ChanceyLab/STM32_F1_GestureRecognition/FDC2214芯片/FDC2214配套资料/看资料之前首先看我哦.pdf

## 技术盒子 FDC2214 相关模块和配套资料使用说明

1：如果购买了 FDC2214 串口转接模块，首先请看 BoxTechFDC2214 串口转接模块使用手册 文档

2：调试传感器参数时，根据 技术盒子 翻译的官方文档说明，调试和设置参数

3. Client 例程为通过串口转接模块来配置和获取 FDC2214 芯片数据的例程
4. 只购买了 FDC2214 传感器模块，看 FDC2214 模块原理图 和翻译的官方文档 自行配置 I2C

# ！！！资料所有权归技术盒子所有，买家享有使权

# 严禁外泄！！！

# 2018-7-02 技术盒子 BOXTECH

## 技术盒子官方店铺 https://shop125570758.taobao.com
