ChanceyLab/STM32_F1_GestureRecognition/指针表盘.docx

猜拳模式 | 石 头 | 剪 刀 | | 布
人机对战
人人对战 | 前者胜 | 平局 | | 后者胜
训练模式 | 第一次 完成 | 第二次 完成 | | 第三次 完成
划拳 模式 | 一 | 二 | | 三
| 四 | | 五
