ChanceyLab/STM32_F1_GestureRecognition/FDC2214芯片/FDC2214配套资料/FDC2214模块原理图.pdf

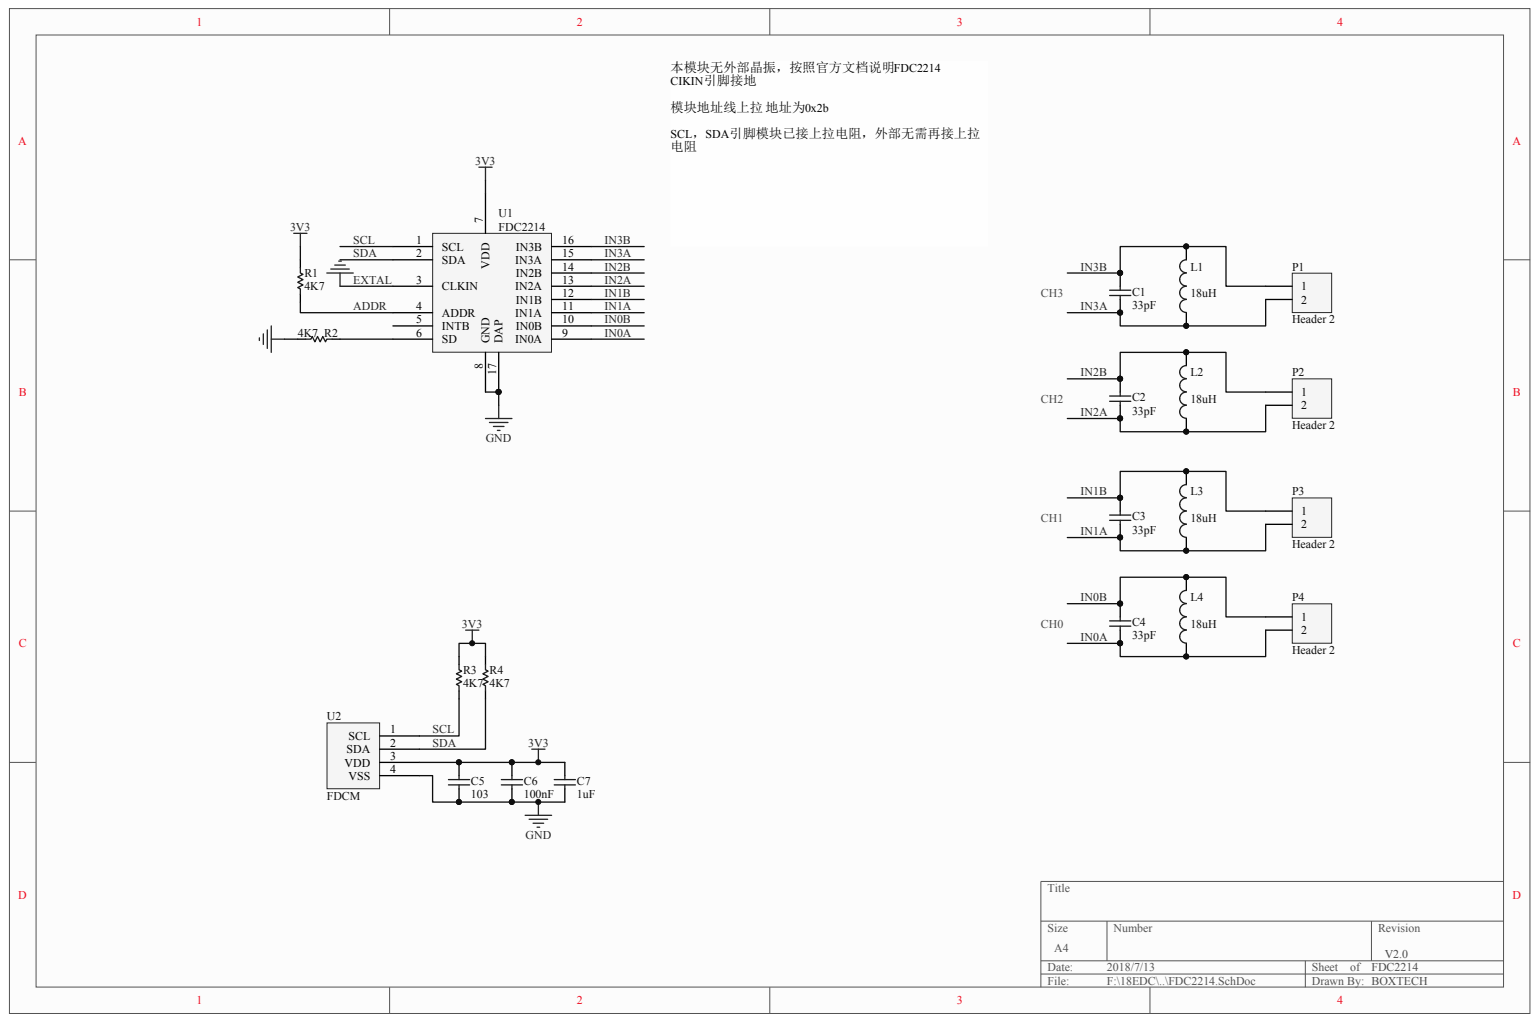
[picture p21: page 1]
