ChanceyLab/STM32_F1_GestureRecognition/FDC2214芯片/FDC2214配套资料/STM32Client/oled/oled.c

//////////////////////////////////////////////////////////////////////////////////	 
//本程序只供学习使用，未经作者许可，不得用于其它任何用途
//中景园电子
//店铺地址：http://shop73023976.taobao.com/?spm=2013.1.0.0.M4PqC2
//
//  文 件 名   : main.c
//  版 本 号   : v2.0
//  作    者   : Evk123
//  生成日期   : 2014-0101
//  最近修改   : 
//  功能描述   : 0.69寸OLED 接口演示例程(STM32F103ZE系列IIC)
//              说明: 
//              ----------------------------------------------------------------
//              GND   电源地
//              VCC   接5V或3.3v电源
//              SCL   接PD6（SCL）
//              SDA   接PD7（SDA）            
//              ----------------------------------------------------------------
//Copyright(C) 中景园电子2014/3/16
//All rights reserved
//////////////////////////////////////////////////////////////////////////////////?

#include "oled.h"
#include "oledfont.h"  	 
#include "stdlib.h"
//OLED的显存
//存放格式如下.
//[0]0 1 2 3 ... 127	
//[1]0 1 2 3 ... 127	
//[2]0 1 2 3 ... 127	
//[3]0 1 2 3 ... 127	
//[4]0 1 2 3 ... 127	
//[5]0 1 2 3 ... 127	
//[6]0 1 2 3 ... 127	
//[7]0 1 2 3 ... 127 			   

void OLED_IIC_Delay(unsigned int t)
{
    int i;
    for( i=0; i<t; i++)
    {
        int a = 6;//6
        while(a--);
    }
}
/**********************************************
//IIC Start
**********************************************/
void OLED_IIC_Start()
{
	OLED_SDIN_Set();
	OLED_SCLK_Set() ;	
	OLED_IIC_Delay(1);
	OLED_SDIN_Clr();
	OLED_IIC_Delay(1);
	OLED_SCLK_Clr();
	
}

/**********************************************
//IIC Stop
**********************************************/
void OLED_IIC_Stop()
{
	OLED_SCLK_Clr();
	OLED_SDIN_Clr();
	OLED_IIC_Delay(1);
	OLED_SCLK_Set();
	OLED_SDIN_Set();
	OLED_IIC_Delay(1);	
}

int OLED_IIC_Wait_Ack()
{
    u16 Out_Time=1000;

    OLED_SDIN_Set();
    OLED_IIC_SDA_In();
    OLED_IIC_Delay(1);
    OLED_SCLK_Set() ;
    OLED_IIC_Delay(1);
    while(OLED_IIC_SDA_Read())
    {
        if(--Out_Time)
        {
            OLED_IIC_Stop();
           // printf("error 2A\r\n");
            return 0xff;
        }
    }
    OLED_SCLK_Clr();
	OLED_IIC_SDA_Out();
    return 0;
}
/**********************************************
// IIC Write byte
**********************************************/

void OLED_Write_IIC_Byte(unsigned char IIC_Byte)
{
    u8 i;
	OLED_SCLK_Clr();
	
    for(i=0; i<8; i++)
    {
        if(IIC_Byte&0x80)
        {
			OLED_SDIN_Set();
        }
        else
        {
            OLED_SDIN_Clr();
        }
        IIC_Byte<<=1;
        OLED_IIC_Delay(1);
        OLED_SCLK_Set();
        OLED_IIC_Delay(1);
        OLED_SCLK_Clr();
    }

}
/**********************************************
// IIC Write Command
**********************************************/
void OLED_Write_IIC_Command(unsigned char IIC_Command)
{
	OLED_IIC_Start();
	OLED_Write_IIC_Byte(0x78);            //Slave address,SA0=0
	OLED_IIC_Wait_Ack();	
	OLED_Write_IIC_Byte(0x00);			//write command
	OLED_IIC_Wait_Ack();	
	OLED_Write_IIC_Byte(IIC_Command); 
	OLED_IIC_Wait_Ack();	
	OLED_IIC_Stop();
}
/**********************************************
// IIC Write Data
**********************************************/
void OLED_Write_IIC_Data(unsigned char IIC_Data)
{
	OLED_IIC_Start();
	OLED_Write_IIC_Byte(0x78);			//D/C#=0; R/W#=0
	OLED_IIC_Wait_Ack();	
	OLED_Write_IIC_Byte(0x40);			//write data
	OLED_IIC_Wait_Ack();	
	OLED_Write_IIC_Byte(IIC_Data);
	OLED_IIC_Wait_Ack();	
	OLED_IIC_Stop();
}
void OLED_WR_Byte(unsigned dat,unsigned cmd)
{
	if(cmd)
	{

		OLED_Write_IIC_Data(dat);

	}
	else {
		OLED_Write_IIC_Command(dat);

	}


}


/********************************************
// fill_Picture
********************************************/
void fill_picture(unsigned char fill_Data)
{
	unsigned char m,n;
	for(m=0;m<8;m++)
	{
		OLED_WR_Byte(0xb0+m,0);		//page0-page1
		OLED_WR_Byte(0x00,0);		//low column start address
		OLED_WR_Byte(0x10,0);		//high column start address
		for(n=0;n<128;n++)
			{
				OLED_WR_Byte(fill_Data,1);
			}
	}
}

//坐标设置

void OLED_Set_Pos(unsigned char x, unsigned char y) 
{ 	OLED_WR_Byte(0xb0+y,OLED_CMD);
	OLED_WR_Byte(((x&0xf0)>>4)|0x10,OLED_CMD);
	OLED_WR_Byte((x&0x0f),OLED_CMD); 
}   	  
//开启OLED显示    
void OLED_Display_On(void)
{
	OLED_WR_Byte(0X8D,OLED_CMD);  //SET DCDC命令
	OLED_WR_Byte(0X14,OLED_CMD);  //DCDC ON
	OLED_WR_Byte(0XAF,OLED_CMD);  //DISPLAY ON
}
//关闭OLED显示     
void OLED_Display_Off(void)
{
	OLED_WR_Byte(0X8D,OLED_CMD);  //SET DCDC命令
	OLED_WR_Byte(0X10,OLED_CMD);  //DCDC OFF
	OLED_WR_Byte(0XAE,OLED_CMD);  //DISPLAY OFF
}		   			 
//清屏函数,清完屏,整个屏幕是黑色的!和没点亮一样!!!	  
void OLED_Clear(void)  
{  
	u8 i,n;		    
	for(i=0;i<8;i++)  
	{  
		OLED_WR_Byte (0xb0+i,OLED_CMD);    //设置页地址（0~7）
		OLED_WR_Byte (0x00,OLED_CMD);      //设置显示位置—列低地址
		OLED_WR_Byte (0x10,OLED_CMD);      //设置显示位置—列高地址   
		for(n=0;n<128;n++)OLED_WR_Byte(0,OLED_DATA); 
	} //更新显示
}
void OLED_On(void)  
{  
	u8 i,n;		    
	for(i=0;i<8;i++)  
	{  
		OLED_WR_Byte (0xb0+i,OLED_CMD);    //设置页地址（0~7）
		OLED_WR_Byte (0x00,OLED_CMD);      //设置显示位置—列低地址
		OLED_WR_Byte (0x10,OLED_CMD);      //设置显示位置—列高地址   
		for(n=0;n<128;n++)OLED_WR_Byte(1,OLED_DATA); 
	} //更新显示
}
//在指定位置显示一个字符,包括部分字符
//x:0~127
//y:0~63
//mode:0,反白显示;1,正常显示				 
//size:选择字体 16/12 
void OLED_ShowChar(u8 x,u8 y,u8 chr,u8 Char_Size)
{      	
	unsigned char c=0,i=0;	
	c=chr-' ';//得到偏移后的值			
	if(x>Max_Column-1){x=0;y=y+2;}
	if(Char_Size ==16)
	{
		OLED_Set_Pos(x,y);	
		for(i=0;i<8;i++)
			OLED_WR_Byte(F8X16[c*16+i],OLED_DATA);
		OLED_Set_Pos(x,y+1);
		for(i=0;i<8;i++)
			OLED_WR_Byte(F8X16[c*16+i+8],OLED_DATA);
	}
	else 
	{	
		OLED_Set_Pos(x,y);
		for(i=0;i<6;i++)
			OLED_WR_Byte(F6x8[c][i],OLED_DATA);

	}
}
//m^n函数
u32 oled_pow(u8 m,u8 n)
{
	u32 result=1;	 
	while(n--)result*=m;    
	return result;
}

//显示数字
//x,y :起点坐标	 
//len :数字的位数
//size:字体大小
//自动清除多余位
//num:数值(0~4294967295);	 		  
void OLED_ShowNum(u8 x,u8 y,u32 num,u8 len,u8 size2)
{
	unsigned char t,temp;
	unsigned char enshow=0;
	unsigned char num_len=0;
	unsigned long j=1; 
	for(t=1;j!=0;t++)	//计算数字位数
	{
		j=num/oled_pow(10,t);
		num_len++;	
	}
	
	for(t=0;t<num_len;t++)
	{
		temp=(num/oled_pow(10,num_len-t-1))%10;
		if(enshow==0&&t<(num_len-1))
		{
			if(temp==0)
			{
				OLED_ShowChar(x+(size2/2)*t,y,' ',size2);
				continue;
			}else enshow=1; 
		 	 
		}
	 	OLED_ShowChar(x+(size2/2)*t,y,temp+'0',size2); 
	}
	
	for(t=num_len;t<len;t++)//空格填充多余位
	{
	 	OLED_ShowChar(x+(size2/2)*t,y,' ',size2); 
	}
} 
//显示一个字符号串
void OLED_ShowString(unsigned char x,unsigned char y,unsigned char *chr,unsigned char Char_Size)
{
	unsigned char j=0;
	while (chr[j]!='\0')
	{		OLED_ShowChar(x,y,chr[j],Char_Size);
			x+=8;
		if(x>120){x=0;y+=2;}
			j++;
	}
}
/***********功能描述：显示显示BMP图片128×64起始点坐标(x,y),x的范围0～127，y为页的范围0～7*****************/
void OLED_DrawBMP(unsigned char x0, unsigned char y0,unsigned char x1, unsigned char y1,unsigned char BMP[])
{ 	
 unsigned int j=0;
 unsigned char x,y;
  
  if(y1%8==0) y=y1/8;      
  else y=y1/8+1;
	for(y=y0;y<y1;y++)
	{
		OLED_Set_Pos(x0,y);
    for(x=x0;x<x1;x++)
	    {      
	    	OLED_WR_Byte(BMP[j++],OLED_DATA);	    	
	    }
	}
} 

//初始化SSD1306					    
void OLED_Init(void)
{ 		 
	GPIO_InitTypeDef   gpio;

	RCC_AHB1PeriphClockCmd(RCC_AHB1Periph_GPIOC,ENABLE);

	gpio.GPIO_Pin = GPIO_Pin_10 | GPIO_Pin_11;
	gpio.GPIO_Mode = GPIO_Mode_OUT;
	gpio.GPIO_OType = GPIO_OType_PP;
	gpio.GPIO_Speed = GPIO_Speed_100MHz;
	GPIO_Init(GPIOC, &gpio);

	GPIO_SetBits(GPIOC,GPIO_Pin_10);
	GPIO_SetBits(GPIOC,GPIO_Pin_11);
	
	OLED_IIC_Delay(200);
	OLED_WR_Byte(0xAE,OLED_CMD);//--display off
	OLED_WR_Byte(0x00,OLED_CMD);//---set low column address
	OLED_WR_Byte(0x10,OLED_CMD);//---set high column address
	OLED_WR_Byte(0x40,OLED_CMD);//--set start line address  
	OLED_WR_Byte(0xB0,OLED_CMD);//--set page address
	OLED_WR_Byte(0x81,OLED_CMD); // contract control
	OLED_WR_Byte(0xFF,OLED_CMD);//--128   
	OLED_WR_Byte(0xA0,OLED_CMD);//set segment remap //x轴反置
	OLED_WR_Byte(0xc0,OLED_CMD);//y轴反置
	OLED_WR_Byte(0xA6,OLED_CMD);//--normal / reverse
	OLED_WR_Byte(0xA8,OLED_CMD);//--set multiplex ratio(1 to 64)
	OLED_WR_Byte(0x3F,OLED_CMD);//--1/32 duty
	OLED_WR_Byte(0xD3,OLED_CMD);//-set display offset
	OLED_WR_Byte(0x00,OLED_CMD);//
	
	OLED_WR_Byte(0xD5,OLED_CMD);//set osc division
	OLED_WR_Byte(0x80,OLED_CMD);//
	
	OLED_WR_Byte(0xD8,OLED_CMD);//set area color mode off
	OLED_WR_Byte(0x05,OLED_CMD);//
	
	OLED_WR_Byte(0xD9,OLED_CMD);//Set Pre-Charge Period
	OLED_WR_Byte(0xF1,OLED_CMD);//
	
	OLED_WR_Byte(0xDA,OLED_CMD);//set com pin configuartion
	OLED_WR_Byte(0x12,OLED_CMD);//
	
	OLED_WR_Byte(0xDB,OLED_CMD);//set Vcomh
	OLED_WR_Byte(0x30,OLED_CMD);//
	
	OLED_WR_Byte(0x8D,OLED_CMD);//set charge pump enable
	OLED_WR_Byte(0x14,OLED_CMD);//
	
	OLED_WR_Byte(0xAF,OLED_CMD);//--turn on oled panel
	
	OLED_Clear();
}  
