ChanceyLab/STM32_F1_GestureRecognition/19-校赛-手势识别 5.10-10/HARDWARE/OLED/oledfount.h

#ifndef __OLEDFONT_H
#define __OLEDFONT_H 	



/***************************************************
汉字阵列，需要取模
软件取字模需设置 -- 宋体、阴码、列行式、逆向输出、十六进制、输出精简、C51格式、去掉行前缀和行后缀的“{”符号
****************************************************/
char F16x16[]=
{	

0x80,0x80,0x80,0x80,0x80,0x80,0x80,0x80,0x80,0x80,0x80,0x80,0x80,0x80,0x80,0x00,
0x00,0x00,0x00,0x00,0x00,0x00,0x00,0x00,0x00,0x00,0x00,0x00,0x00,0x00,0x00,0x00,//一     0
	
0x00,0x00,0x08,0x08,0x08,0x08,0x08,0x08,0x08,0x08,0x08,0x08,0x08,0x00,0x00,0x00,
0x10,0x10,0x10,0x10,0x10,0x10,0x10,0x10,0x10,0x10,0x10,0x10,0x10,0x10,0x10,0x00,//二    1

0x00,0x04,0x84,0x84,0x84,0x84,0x84,0x84,0x84,0x84,0x84,0x84,0x84,0x04,0x00,0x00,
0x20,0x20,0x20,0x20,0x20,0x20,0x20,0x20,0x20,0x20,0x20,0x20,0x20,0x20,0x20,0x00,//三     2

0x00,0xFC,0x04,0x04,0x04,0xFC,0x04,0x04,0x04,0xFC,0x04,0x04,0x04,0xFC,0x00,0x00,
0x00,0x7F,0x28,0x24,0x23,0x20,0x20,0x20,0x20,0x21,0x22,0x22,0x22,0x7F,0x00,0x00,//4   3
	
0x00,0x02,0x42,0x42,0x42,0xC2,0x7E,0x42,0x42,0x42,0x42,0xC2,0x02,0x02,0x00,0x00,
0x40,0x40,0x40,0x40,0x78,0x47,0x40,0x40,0x40,0x40,0x40,0x7F,0x40,0x40,0x40,0x00,//5    4
	
0x02,0x02,0x02,0x02,0xC2,0xB2,0x8E,0x82,0x82,0x82,0x82,0x82,0x82,0x02,0x02,0x00,
0x08,0x04,0x02,0x01,0xFF,0x40,0x40,0x40,0x40,0x40,0x40,0x40,0xFF,0x00,0x00,0x00,//石   5

0x00,0x00,0x10,0x60,0x04,0x18,0x00,0x00,0xFF,0x00,0x00,0x00,0x00,0x00,0x00,0x00,
0x81,0x81,0x41,0x41,0x21,0x11,0x09,0x07,0x01,0x05,0x09,0x11,0x21,0xC1,0x01,0x00,//头    6 

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
0x00,0x00,0x00,0xFF,0xFF,0xFF,0x00,0x01,0x03,0x03,0x01,0x01,0xFF,0xFF,0xFF,0x01,
0x01,0x01,0x01,0x01,0x01,0x00,0x00,0x00,0x0E,0x07,0x03,0x00,0x00,0x03,0x03,0x0F,
0x0F,0x07,0x03,0x06,0x06,0x02,0x02,0x02,0x02,0x03,0x03,0x03,0x02,0x02,0x02,0x03,
0x03,0x03,0x02,0x00,	
};


#endif
