ChanceyLab/STM32_F1_GestureRecognition/(notices)

Notices in the files:
19-FDC2214模块/SYSTEM/usart/usart.c:
Copyright(C) ¹ãÖÝÊÐÐÇÒíµç×Ó¿Æ¼¼ÓÐÏÞ¹«Ë¾ 2009-2019
All rights reserved
FDC2214芯片/FDC2214配套资料/STM32Client/oled/oled.c:
Copyright(C) ÖÐ¾°Ô°µç×Ó2014/3/16
